mwelling/latchup-badge/README.md

# Fossi LATCH-UP Badge (Unofficial)
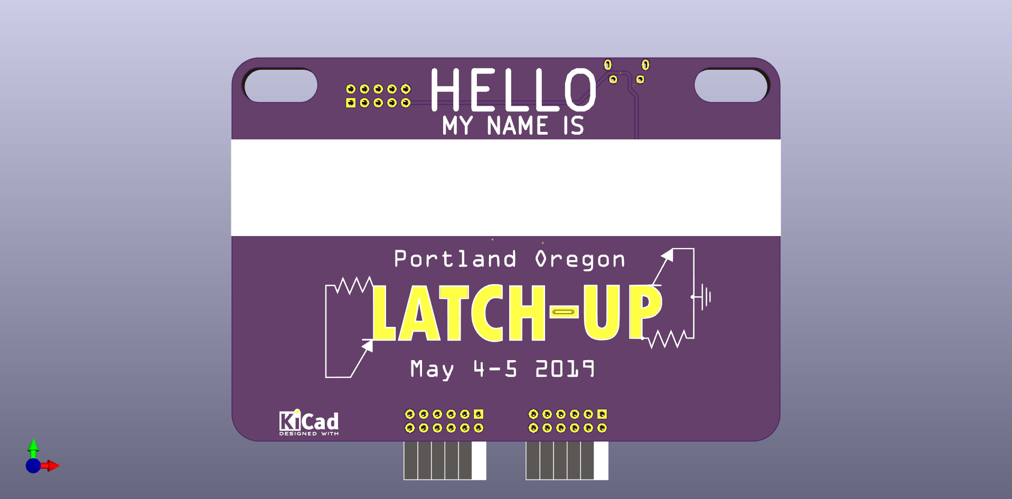
[picture p1: latchup-badge.png]
LATCHUP

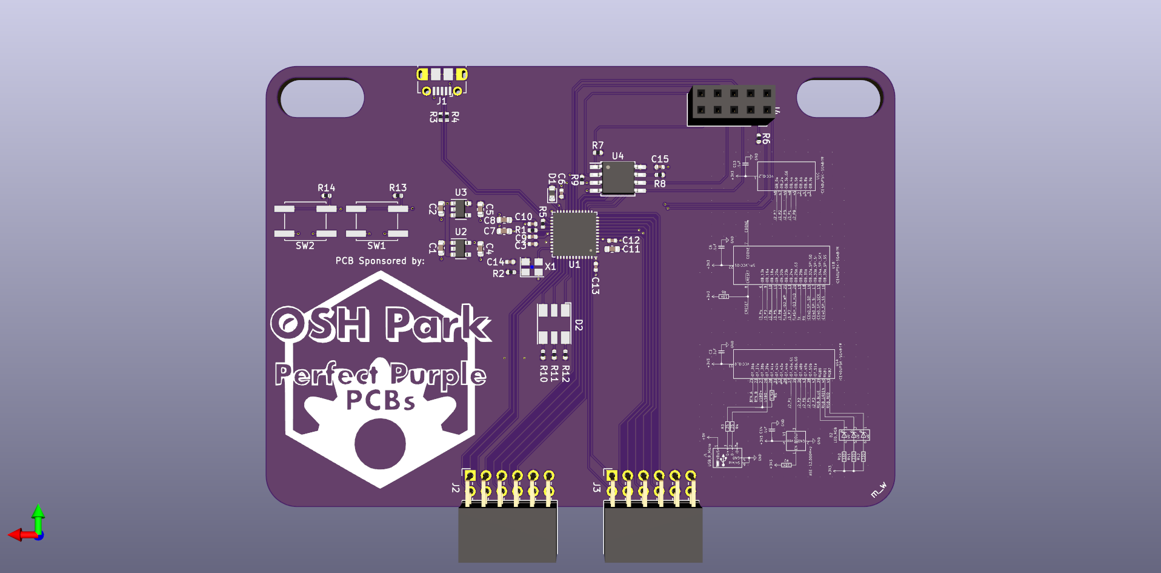
[picture p2: latchup-badge-back.png]
LATCHUP
