mwelling/latchup-badge/latchup-badge.pdf

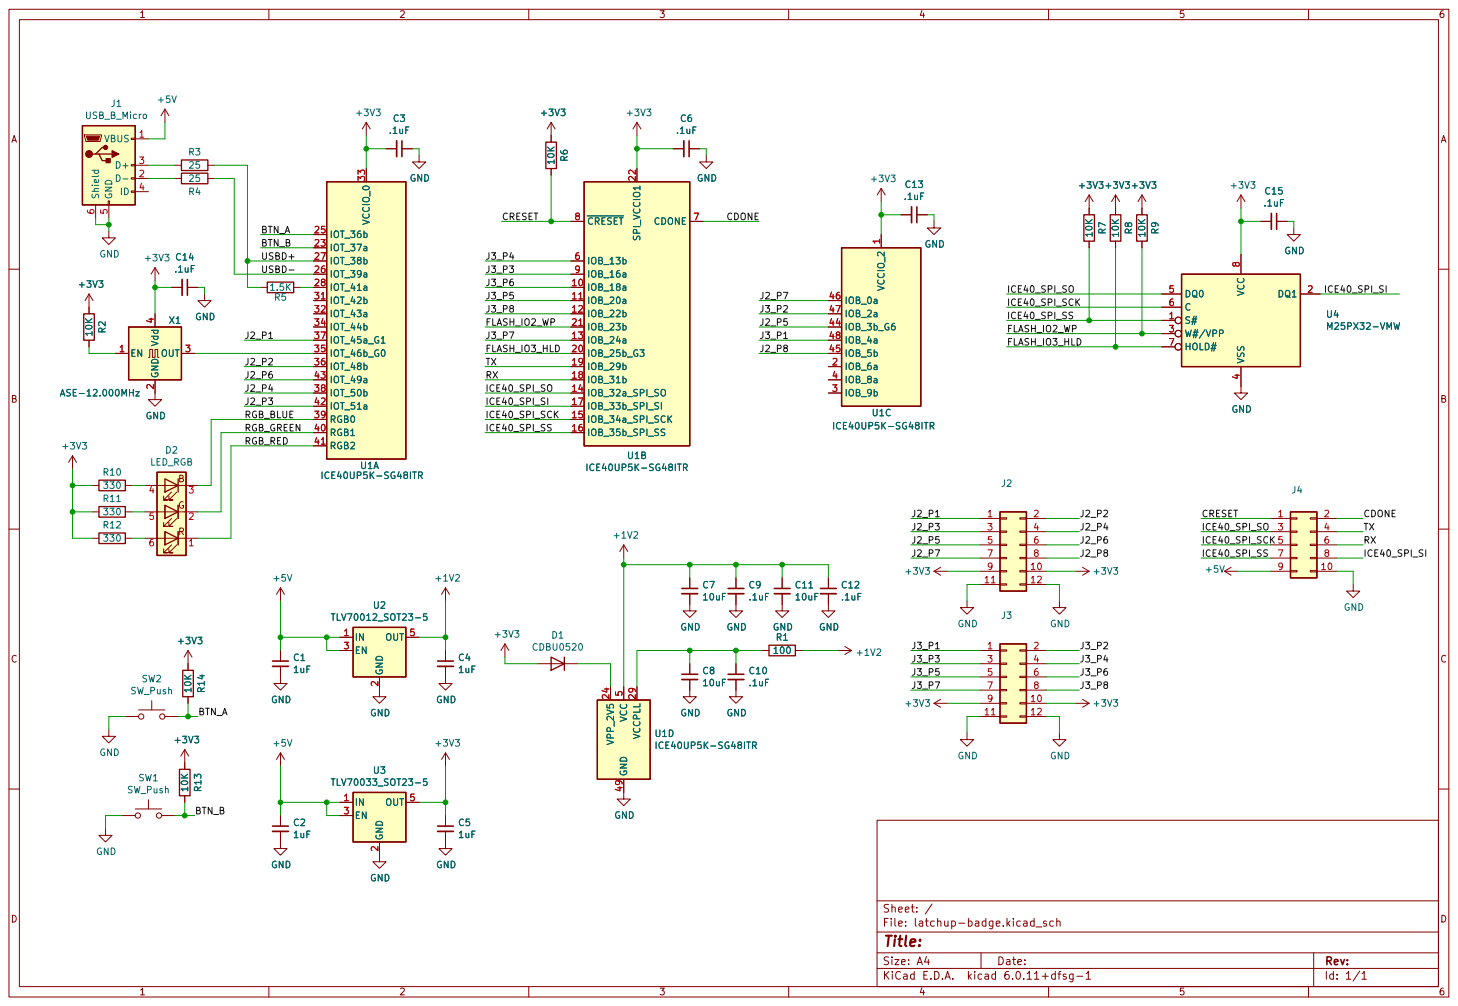
[picture p3: page 1]

Id: 1/1 Title: File: latchup-badge.kicad_sch Sheet: / C8
10uF GND
