mwelling/latchup-badge/latchup-badge.kicad_pcb

## KiCad design latchup-badge.kicad_pcb (2024-04-14)

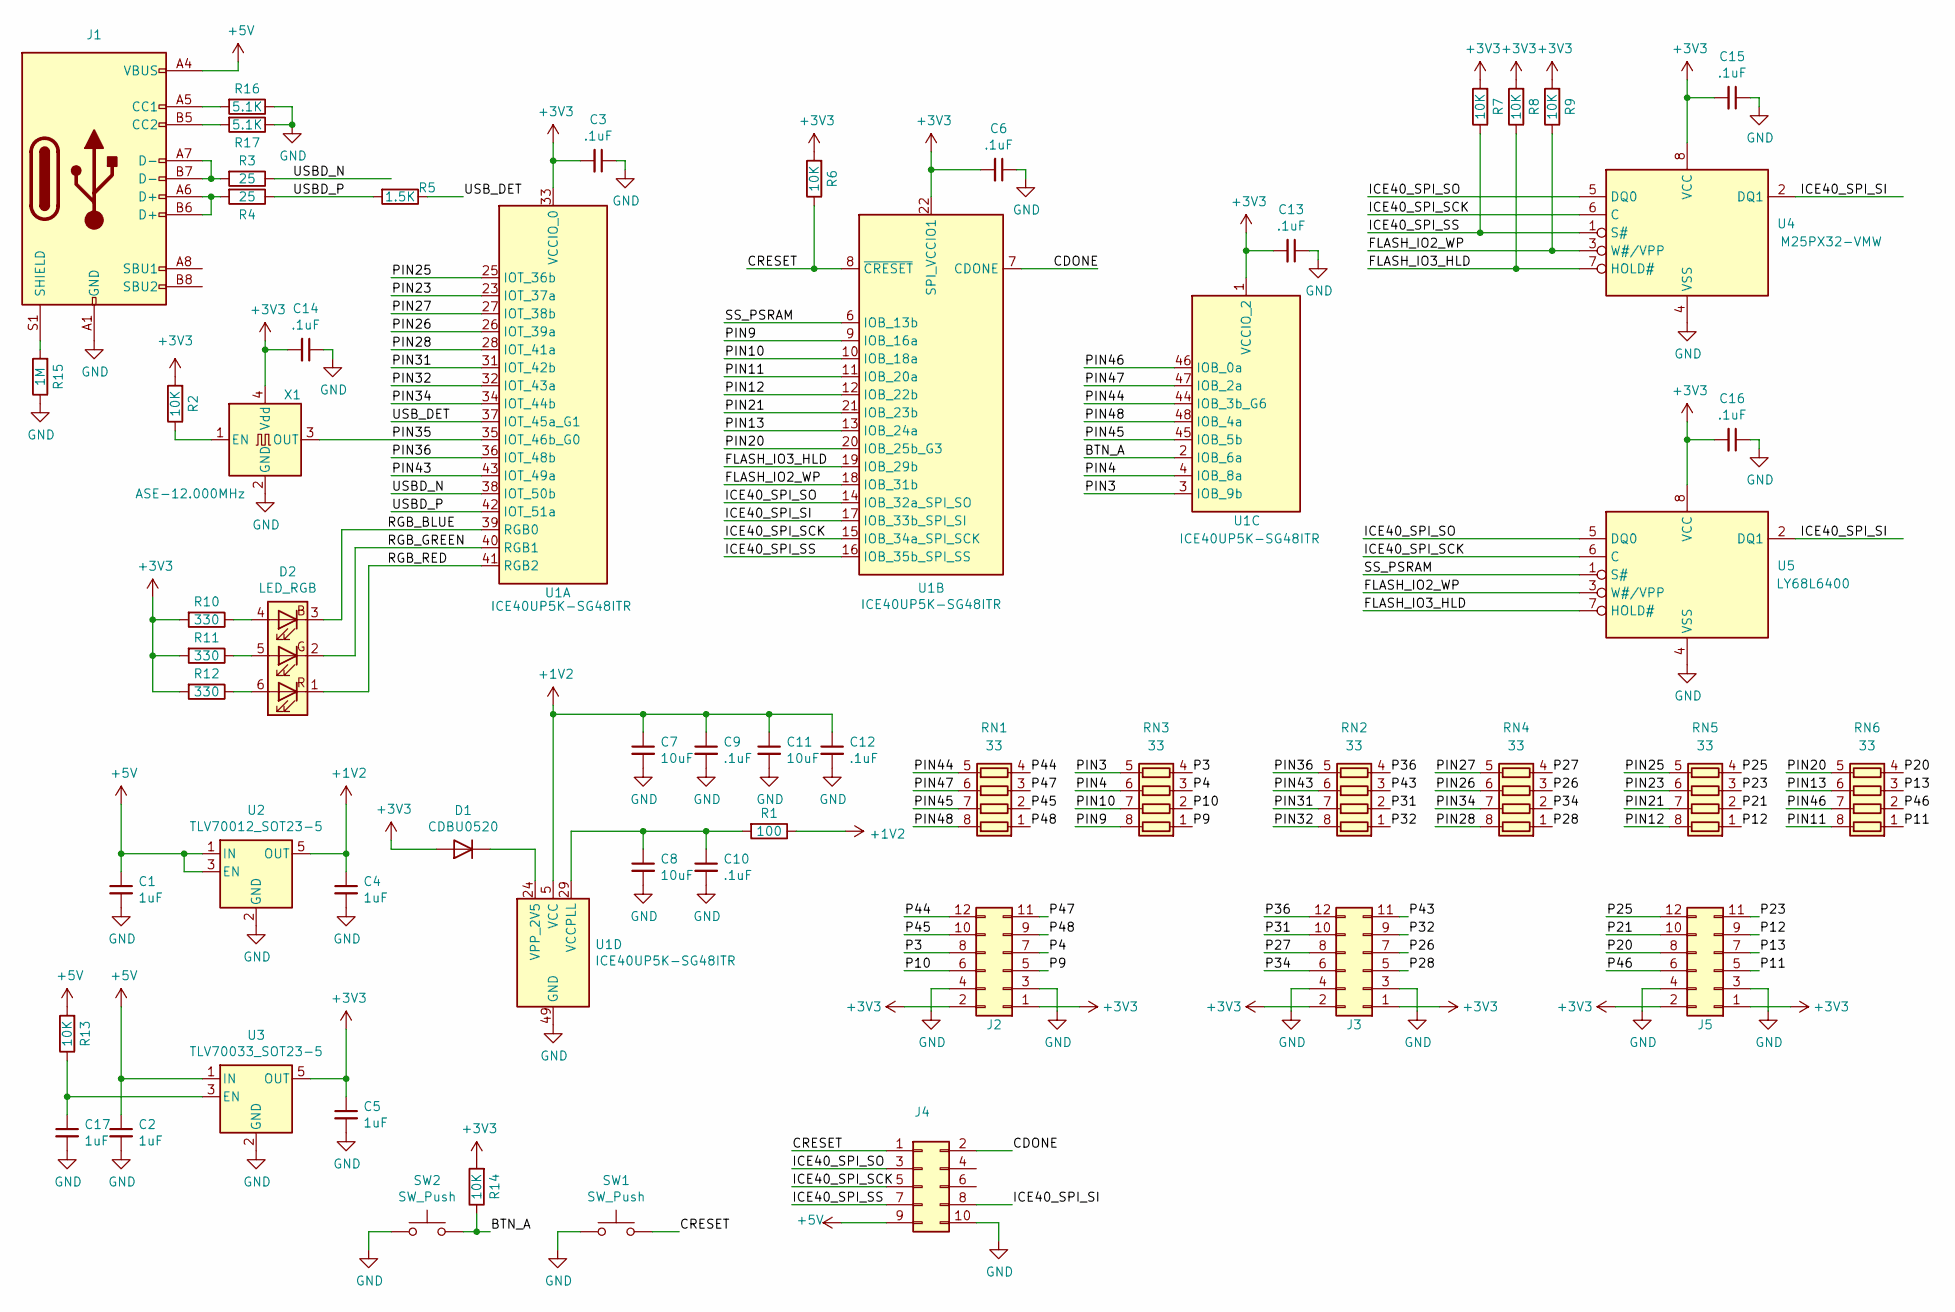
[picture p4: schematic latchup-badge.kicad_sch]

Parts:
C1, C2, C4, C5, C17: 1uF; C_0603_1608Metric
C3, C6, C9, C10, C12, C13, C14, C15, C16: .1uF; C_0402_1005Metric
C7, C8, C11: 10uF; C_0603_1608Metric
D1: CDBU0520; D_0603_1608Metric
D2: LED_RGB; LED_RGB_PLLC-6
J1: USB_C_Receptacle_USB2.0; USB_C_Receptacle_HRO_TYPE-C-31-M-12
J2, J3, J5: Connector_Generic:Conn_02x06_Odd_Even; PinSocket_2x06_P2.54mm_Horizontal
J4: Connector_Generic:Conn_02x05_Odd_Even; PinSocket_2x05_P2.54mm_Vertical
R1: 100; R_0402_1005Metric
R2, R6, R7, R8, R9, R13, R14: 10K; R_0402_1005Metric
R3, R4: 25; R_0402_1005Metric
R5: 1.5K; R_0402_1005Metric
R10, R11, R12: 330; R_0402_1005Metric
R15: 1M; R_0402_1005Metric
R16, R17: 5.1K; R_0402_1005Metric
RN1, RN2, RN3, RN4, RN5, RN6: 33; R_Array_Concave_4x0402
SW1, SW2: SW_Push; SW_SPST_EVQQ2
U1: ICE40UP5K-SG48ITR; QFN-48-1EP_7x7mm_P0.5mm_EP5.6x5.6mm
U2: TLV70012_SOT23-5; SOT-23-5
U3: TLV70033_SOT23-5; SOT-23-5
U4: M25PX32-VMW; SOIC-8W_5.3x5.3mm_P1.27mm
U5: LY68L6400; SOIC-8_3.9x4.9mm_P1.27mm
X1: ASE-12.000MHz; Oscillator_SMD_Abracon_ASE-4Pin_3.2x2.5mm

Connections:
+1V2: C4.1, C7.1, C9.1, C11.1, C12.1, R1.1, U1.5 (VCC), U1.30 (VCC), U2.5 (OUT)
+3V3: C3.2, C5.1, C6.2, C13.2, C14.2, C15.2, C16.2, D1.2 (A), J2.1, J2.2, J3.1, J3.2, J5.1, J5.2, R2.2, R6.2, R7.2, R8.2, R9.2, R10.2, R11.2, R12.2, R14.2, U1.1 (VCCIO_2), U1.22 (SPI_VCCIO1), U1.33 (VCCIO_0), U3.5 (OUT), U4.8 (VCC), U5.8 (VCC), X1.4 (Vdd)
+5V: C1.1, C2.1, J1.A4 (VBUS), J1.A9 (VBUS), J1.B4 (VBUS), J1.B9 (VBUS), J4.9, R13.2, U2.1 (IN), U2.3 (EN), U3.1 (IN)
/BTN_A: R14.1, SW2.2, U1.2 (IOB_6a)
/CDONE: J4.2, U1.7 (CDONE)
/CRESET: J4.1, R6.1, SW1.2, U1.8 (~CRESET)
/FLASH_IO2_WP: R9.1, U1.18 (IOB_31b), U4.3 (W#/VPP), U5.3 (W#/VPP)
/FLASH_IO3_HLD: R8.1, U1.19 (IOB_29b), U4.7 (HOLD#), U5.7 (HOLD#)
/ICE40_SPI_SCK: J4.5, U1.15 (IOB_34a_SPI_SCK), U4.6 (C), U5.6 (C)
/ICE40_SPI_SI: J4.8, U1.17 (IOB_33b_SPI_SI), U4.2 (DQ1), U5.2 (DQ1)
/ICE40_SPI_SO: J4.3, U1.14 (IOB_32a_SPI_SO), U4.5 (DQ0), U5.5 (DQ0)
/ICE40_SPI_SS: J4.7, R7.1, U1.16 (IOB_35b_SPI_SS), U4.1 (S#)
/P3: J2.8, RN3.4 (R4.1)
/P4: J2.7, RN3.3 (R3.1)
/P9: J2.5, RN3.1 (R1.1)
/P10: J2.6, RN3.2 (R2.1)
/P11: J5.5, RN6.1 (R1.1)
/P12: J5.9, RN5.1 (R1.1)
/P13: J5.7, RN6.3 (R3.1)
/P20: J5.8, RN6.4 (R4.1)
/P21: J5.10, RN5.2 (R2.1)
/P23: J5.11, RN5.3 (R3.1)
/P25: J5.12, RN5.4 (R4.1)
/P26: J3.7, RN4.3 (R3.1)
/P27: J3.8, RN4.4 (R4.1)
/P28: J3.5, RN4.1 (R1.1)
/P31: J3.10, RN2.2 (R2.1)
/P32: J3.9, RN2.1 (R1.1)
/P34: J3.6, RN4.2 (R2.1)
/P36: J3.12, RN2.4 (R4.1)
/P43: J3.11, RN2.3 (R3.1)
/P44: J2.12, RN1.4 (R4.1)
/P45: J2.10, RN1.2 (R2.1)
/P46: J5.6, RN6.2 (R2.1)
/P47: J2.11, RN1.3 (R3.1)
/P48: J2.9, RN1.1 (R1.1)
/PIN3: RN3.5 (R4.2), U1.3 (IOB_9b)
/PIN4: RN3.6 (R3.2), U1.4 (IOB_8a)
/PIN9: RN3.8 (R1.2), U1.9 (IOB_16a)
/PIN10: RN3.7 (R2.2), U1.10 (IOB_18a)
/PIN11: RN6.8 (R1.2), U1.11 (IOB_20a)
/PIN12: RN5.8 (R1.2), U1.12 (IOB_22b)
/PIN13: RN6.6 (R3.2), U1.13 (IOB_24a)
/PIN20: RN6.5 (R4.2), U1.20 (IOB_25b_G3)
/PIN21: RN5.7 (R2.2), U1.21 (IOB_23b)
/PIN23: RN5.6 (R3.2), U1.23 (IOT_37a)
/PIN25: RN5.5 (R4.2), U1.25 (IOT_36b)
/PIN26: RN4.6 (R3.2), U1.26 (IOT_39a)
/PIN27: RN4.5 (R4.2), U1.27 (IOT_38b)
/PIN28: RN4.8 (R1.2), U1.28 (IOT_41a)
/PIN31: RN2.7 (R2.2), U1.31 (IOT_42b)
/PIN32: RN2.8 (R1.2), U1.32 (IOT_43a)
/PIN34: RN4.7 (R2.2), U1.34 (IOT_44b)
/PIN35: U1.35 (IOT_46b_G0), X1.3 (OUT)
/PIN36: RN2.5 (R4.2), U1.36 (IOT_48b)
/PIN43: RN2.6 (R3.2), U1.43 (IOT_49a)
/PIN44: RN1.5 (R4.2), U1.44 (IOB_3b_G6)
/PIN45: RN1.7 (R2.2), U1.45 (IOB_5b)
/PIN46: RN6.7 (R2.2), U1.46 (IOB_0a)
/PIN47: RN1.6 (R3.2), U1.47 (IOB_2a)
/PIN48: RN1.8 (R1.2), U1.48 (IOB_4a)
/RGB_BLUE: D2.3 (BK), U1.39 (RGB0)
/RGB_GREEN: D2.2 (GK), U1.40 (RGB1)
/RGB_RED: D2.1 (RK), U1.41 (RGB2)
/SS_PSRAM: U1.6 (IOB_13b), U5.1 (S#)
/USBD_N: R3.1, U1.38 (IOT_50b)
/USBD_P: R4.1, R5.2, U1.42 (IOT_51a)
/USB_DET: R5.1, U1.37 (IOT_45a_G1)
GND: C1.2, C2.2, C3.1, C4.2, C5.2, C6.1, C7.2, C8.2, C9.2, C10.2, C11.2, C12.2, C13.1, C14.1, C15.1, C16.1, C17.2, J1.A1 (GND), J1.A12 (GND), J1.B1 (GND), J1.B12 (GND), J2.3, J2.4, J3.3, J3.4, J4.10, J5.3, J5.4, R15.1, R16.1, R17.1, SW1.1, SW2.1, U1.49 (GND), U2.2 (GND), U3.2 (GND), U4.4 (VSS), U5.4 (VSS), X1.2 (GND)
unnamed: C8.1, C10.1, R1.2, U1.29 (VCCPLL)
unnamed: C17.1, R13.1, U3.3 (EN)
unnamed: D1.1 (K), U1.24 (VPP_2V5)
unnamed: D2.4 (BA), R10.1
unnamed: D2.5 (GA), R11.1
unnamed: D2.6 (RA), R12.1
unnamed: J1.A5 (CC1), R16.2
unnamed: J1.A6 (D+), J1.B6 (D+), R4.2
unnamed: J1.A7 (D-), J1.B7 (D-), R3.2
unnamed: J1.B5 (CC2), R17.2
unnamed: J1.S1 (SHIELD), R15.2
unnamed: R2.1, X1.1 (EN)

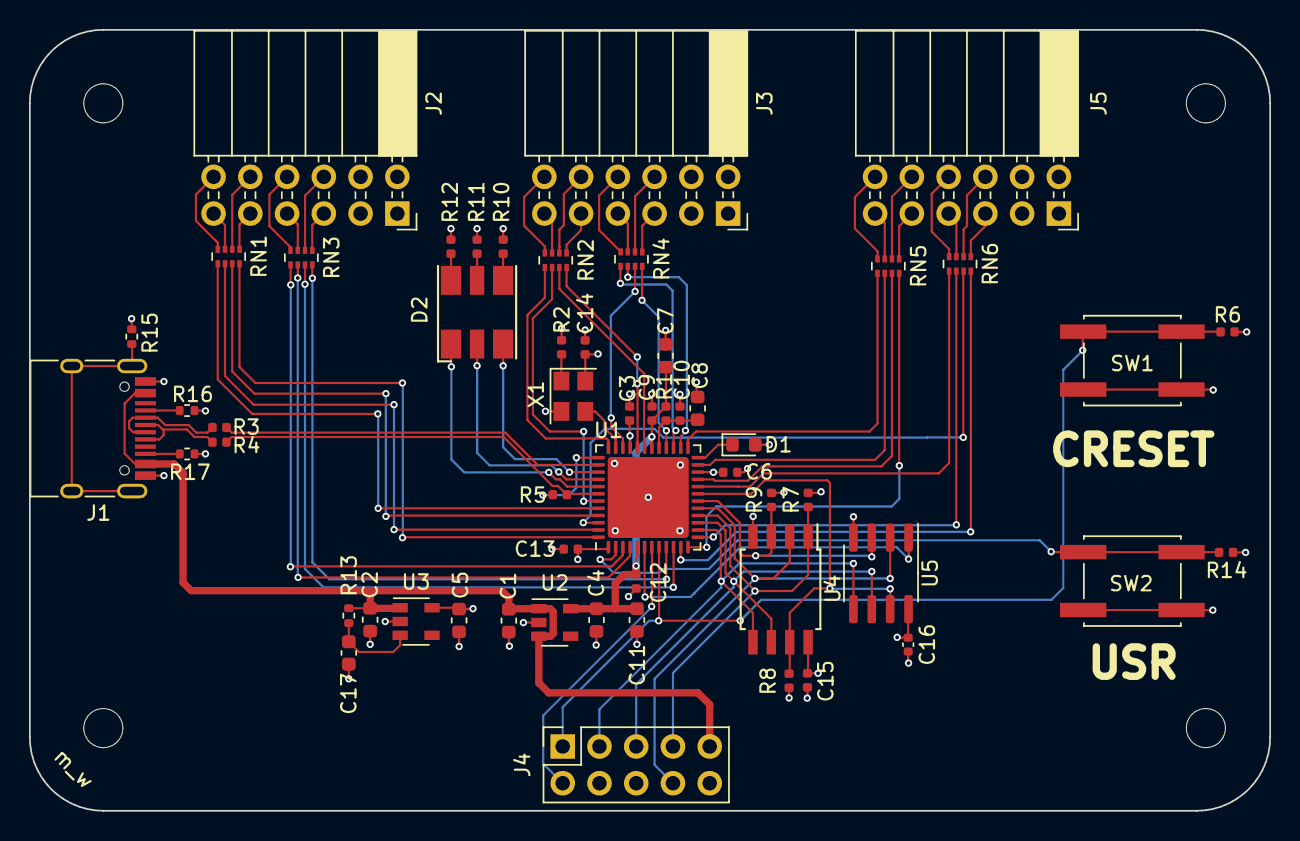
[picture p5: board latchup-badge.kicad_pcb from above]

Board: 4 copper layers, 85.7 x 54.0 mm, 55 parts (0 on the bottom side), 81 nets.
