mwelling/latchup-badge/(commit log)

2019-03-28 Add some initial circuitry
    Adds ICE40, regulators, SPI flash.
    [latchup-badge.kicad_pcb, latchup-badge.sch]
2019-04-11 Moar updates
    [latchup-badge.kicad_pcb, latchup-badge.sch]
2019-04-14 Add some artwork
    [latchup-badge.kicad_pcb, latchup-badge.sch]
2019-04-15 Add some headers and route
    Some small tweaks left but mostly done.
    [latchup-badge.kicad_pcb, latchup-badge.sch]
2019-04-16 OSHPark is sponsoring the PCBs!
    [latchup-badge.kicad_pcb, latchup-badge.sch]
2019-04-16 Tweak routing per review from tnt
    Gives the GND plane more room to breathe.
    [latchup-badge.kicad_pcb]
2019-04-16 Add RGB and a few buttons
    Ready final review.
    [latchup-badge.kicad_pcb, latchup-badge.sch]
2019-04-16 See everyone at Latchup!
    This is puppy is going to the fab.
    [latchup-badge.kicad_pcb, latchup-badge.sch]
2024-02-08 Update to Kicad 6
    [latchup-badge.kicad_pcb, latchup-badge.kicad_sch, latchup-badge.sch]
2024-02-12 Switch to USB-C connector and shrink board
    [latchup-badge.kicad_pcb, latchup-badge.kicad_sch]
2024-03-02 Add PSRAM
    [latchup-badge.kicad_pcb, latchup-badge.kicad_sch]
2024-03-04 Update PSRAM footprint
    [latchup-badge.kicad_pcb, latchup-badge.kicad_sch]
2024-03-04 Use the PMOD pinout from icebreaker bitsy breakout
    [latchup-badge.kicad_pcb, latchup-badge.kicad_sch]
2024-03-04 Add delay to 3.3V enable
    The 1.2V rail should be up before 3.3V.
    [latchup-badge.kicad_pcb, latchup-badge.kicad_sch]
2024-03-04 Add series damping resistors on PMODs
    [latchup-badge.kicad_pcb, latchup-badge.kicad_sch]
2024-04-14 Routed board
    Switched to 4 layer design and routed it.
    [latchup-badge.kicad_pcb]
